WVERCR/Linefollower/readme.md

# LineFollower

lege repository die je als template kan gebruiken om een eigen repository te starten voor uw linefollower project
ward

## specifications

microcontroller: Arduino Leonardo

motors: 50:1 Micro Metal gearmotors HPB 6V

h-bridge: 	DRV8833 Bipolaire Stappenmotor- en DC-Motoraansturing

sensors: QTR8 Reflectance Sensor array 

batteries: 6x AA batterijen 1.5V

wireless communication: 	HC-05 Bluetooth module

distance sensor - motors: /

weight:

speed:
