WVERCR/Linefollower/bill of materials/readme.md

## bill of materials
<br />

|volgnummer|naam |omschrijving |nieuw/recup|kostprijs/stuk|aantal|subtotaal|
|---|---|---|---|---|---|---|
| 1|Microcontroller |Microcontroller arduino leonardo | recup |€ 0 |  1 |€ 0,00 |
| 2|DRV8833 |DRV8833 Bipolaire Stappenmotor- en DC-Motoraansturing | nieuw |€ 3,49 |  1 |€ 3,49 |
| 3|HC-05 |HC-05 Bluetooth module | nieuw |€ 5,00 |  1 |€ 5,00 |
| 4|QTR-8 |Reflectance Sensor array | nieuw |€ 8,18 |  1 |€ 8,18 |
| 5|Motor |50:1 Micro Metal gearmotors HPB 6V | nieuw |€ 2,85 |  1 |€ 2,85 |
| 6|breadbord |breadbord 82mm op 54mm | nieuw |€ 1,72 |  1 |€ 1,72 |
| 7|Batterijen |6x AA batterijen 1.5V | nieuw |€ 11,00 |  1 |€ 11,00  |
| 8|Batterijhouder  |6xAA Batterijhouder | recup |€ 0 |  1 |€ 0 |
| 9|Wielen |Wiel dia:41mm -2 stuks | nieuw |€ 1,94 |  2 |€ 3,88 |
| 10|Drukknop |Drukknop | recup |€ 0 |  1 |€ 0 |
| 11|Led blauw |Blauwe led | recup |€ 0 |  1 |€ 0 |
| 12|Weerstand 220 Ω |Weerstand 220 Ω | recup |€ 0 |  1 |€ 0 |
| 13|Weerstand 680 Ω |Weerstand 680 Ω | recup |€ 0 |  1 |€ 0 |  
| 14|Printplaat |Printplaat 7cm X 9cm | nieuw |€ 1,39 |  1 |€ 1,39 |
| 15|bout en moer |Bout M3*15 en moer M3 | recup |€ 0 |  2 |€ 0 |
| 16|kabels |kabels | nieuw |€ 3,51 |  30  |€ 3,51 |
