WVERCR/Linefollower/code/proof of concepts/hbridge/Schematic_sensor_2024-10-14.pdf

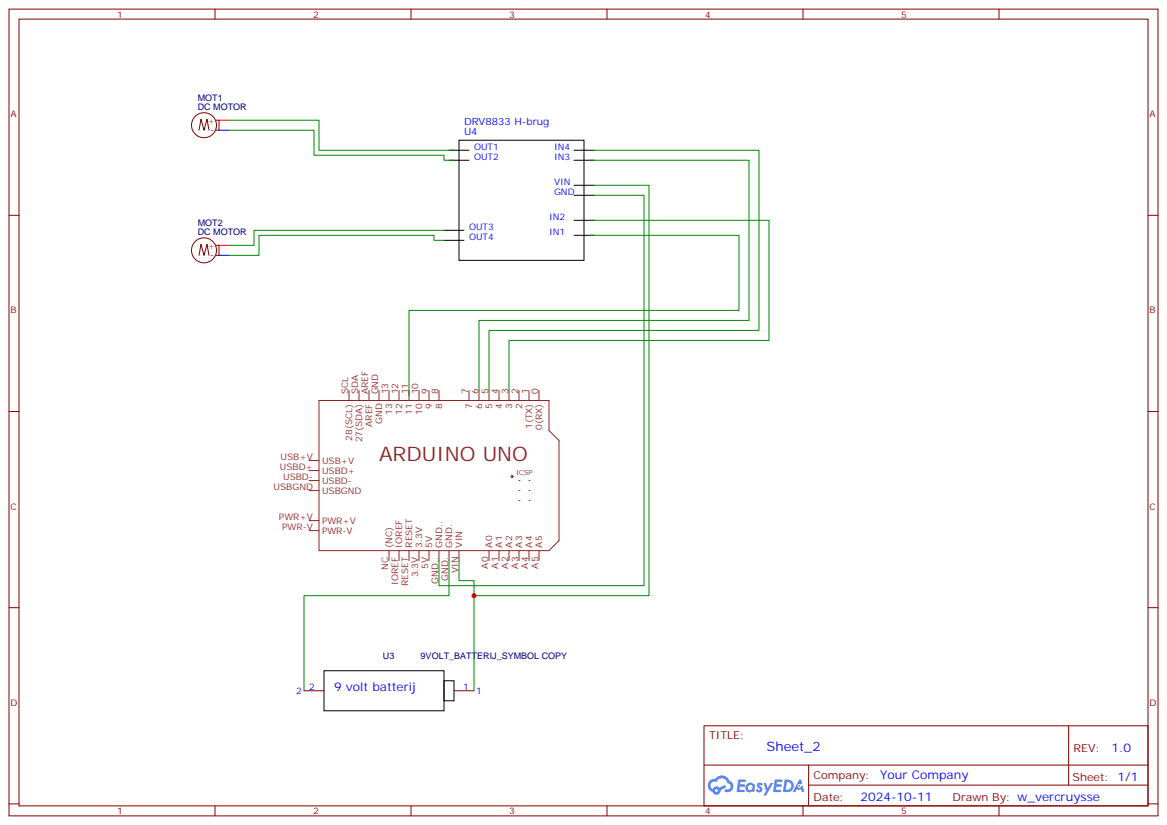
[picture p2: page 1]

9 10 10 11 11 12 12 13 13 GND GND AREF AREF 27(SDA) SDA 28(SCL) SCL
