WVERCR/Linefollower/code/finaal/totaalschema.pdf

## 2 9 volt batterij

HC-05

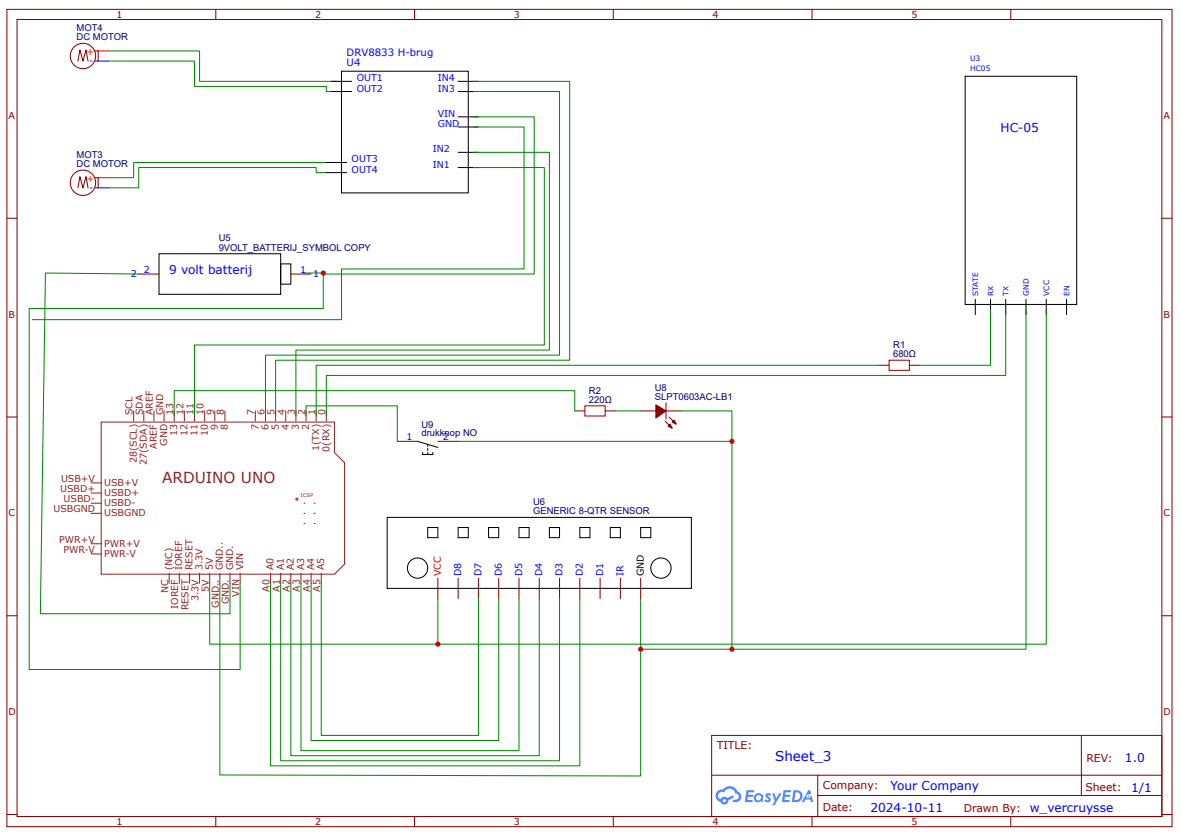
[picture p3: page 1]

VIN GND. GND. GND.. GND..
