WVERCR/Linefollower/technische tekeningen/elektronisch/h-brug.pdf

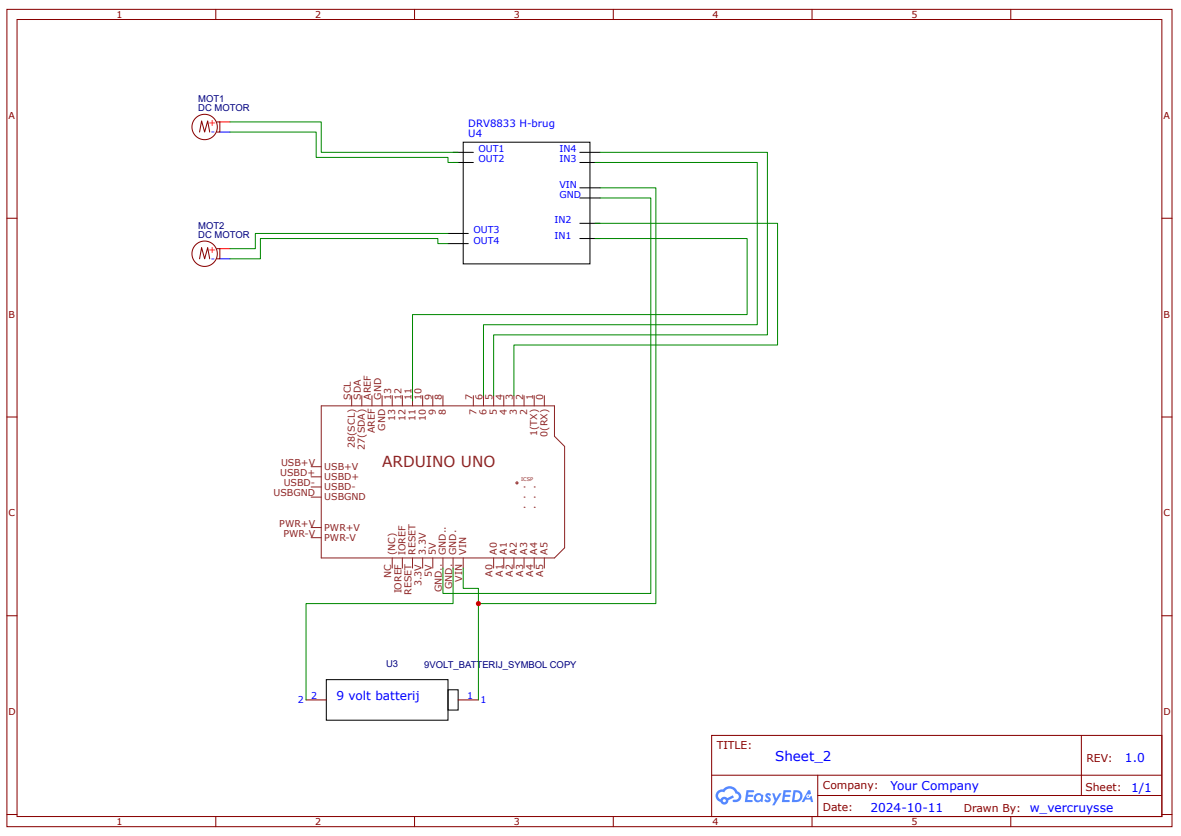
[picture p4: page 1]
TITLE:; Sheet_2; REV: 1.0; Date:; Sheet: 1/1 Drawn By: w_vercruysse; ICSP; USB+V; ARDUINO UNO; USBD+; USBD+ USBD- USBD- USBGND; USBGND; PWR+V; PWR-V; IOREF; RESET RESET 3.3V; GND.. GND.. GND. GND. VIN; VIN; 13 GND GND; AREF AREF 27(SDA) SDA 28(SCL) SCL; 9VOLT_BATTERIJ_SYMBOL COPY; 9 volt batterij; DC MOTOR; MOT1; MOT2; VIN GND; OUT2; OUT1; OUT3 OUT4; DRV8833 H-brug U4

Company: Your Company
