WVERCR/Linefollower/technische tekeningen/elektronisch/communicatie.pdf

HC-05

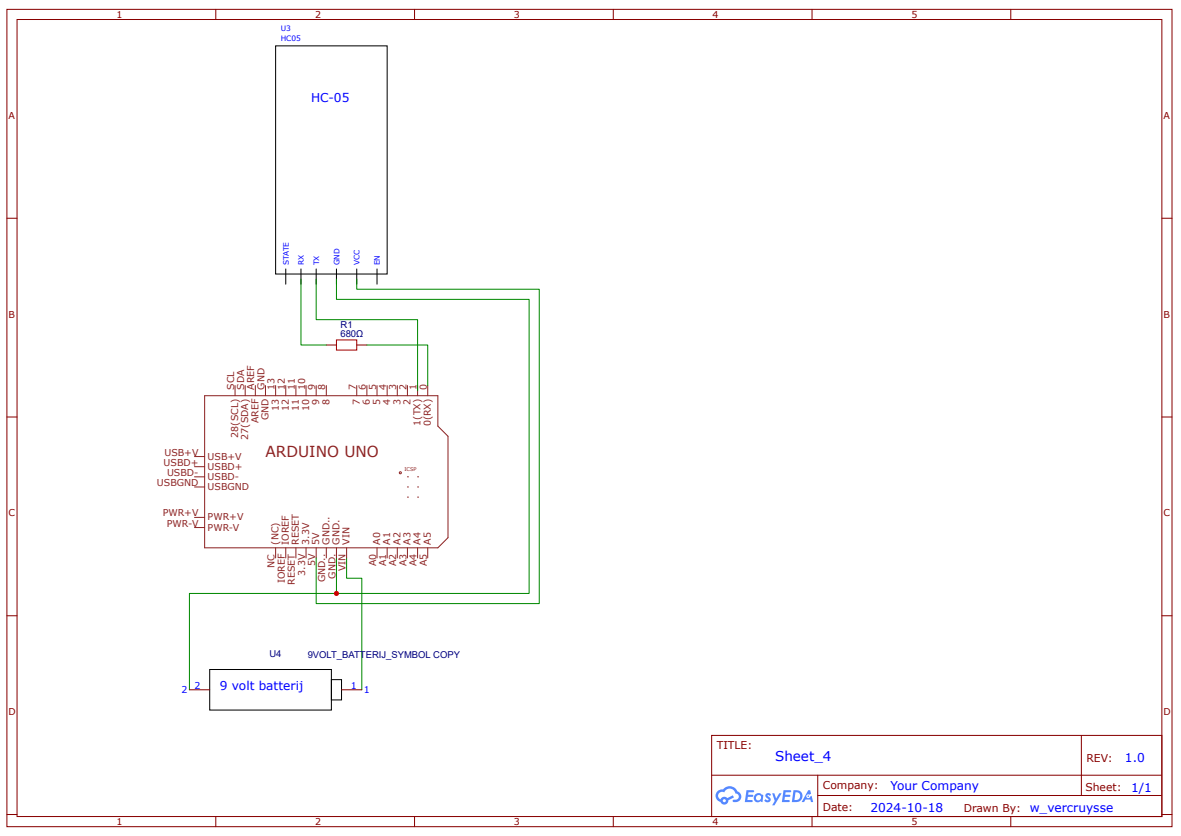
[picture p5: page 1]
TITLE:; Sheet_4; REV: 1.0; Date:; Sheet: 1/1 Drawn By: w_vercruysse; STATE; GND; VCC; 9VOLT_BATTERIJ_SYMBOL COPY; 9 volt batterij; 28(SCL) SCL; 27(SDA) SDA; AREF AREF GND GND; VIN; 3.3V RESET RESET IOREF; IOREF; PWR-V; PWR+V; USBGND; USBD- USBD-; USBD+; USB+V USB+V; ARDUINO UNO; ICSP

VIN GND. GND. GND.. GND..

Company: Your Company
