WVERCR/Linefollower/technische tekeningen/elektronisch/sensor.pdf

## 2 9 volt batterij

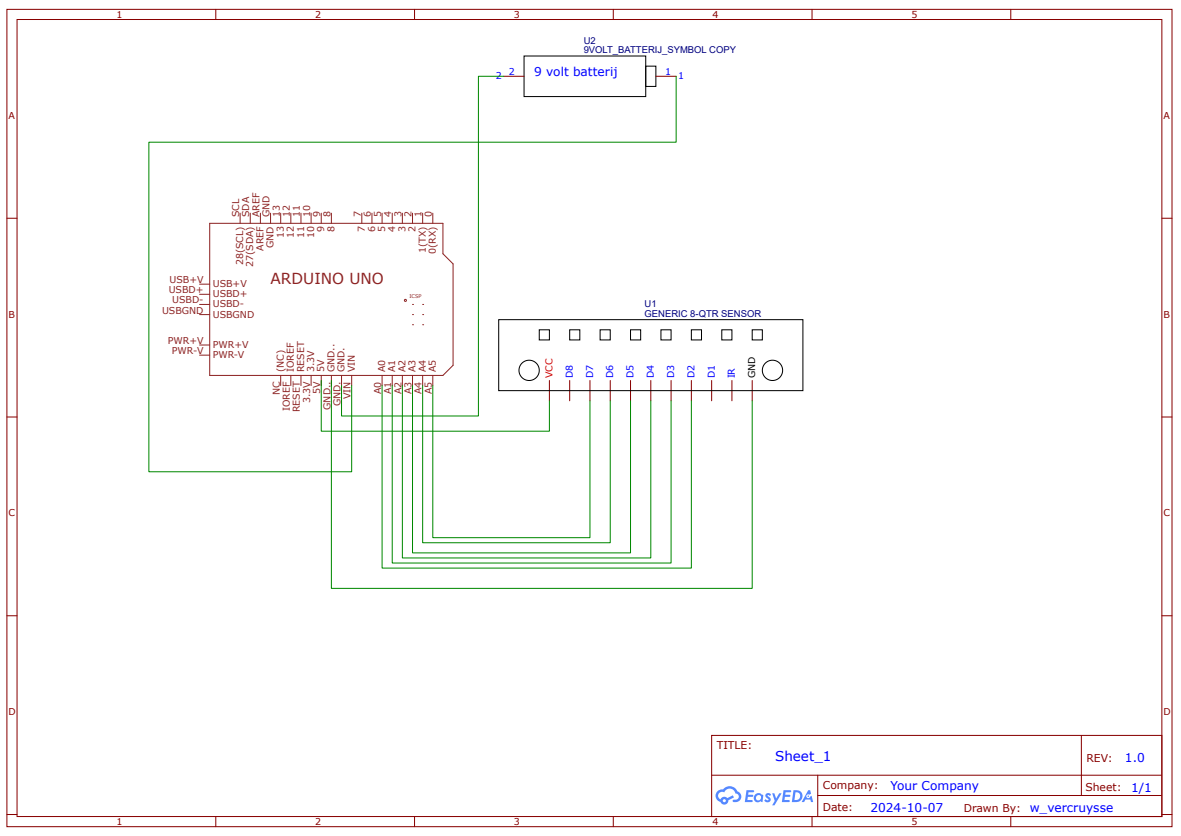
[picture p6: page 1]
