WVERCR/Linefollower/technische tekeningen/elektronisch/interrupt.pdf

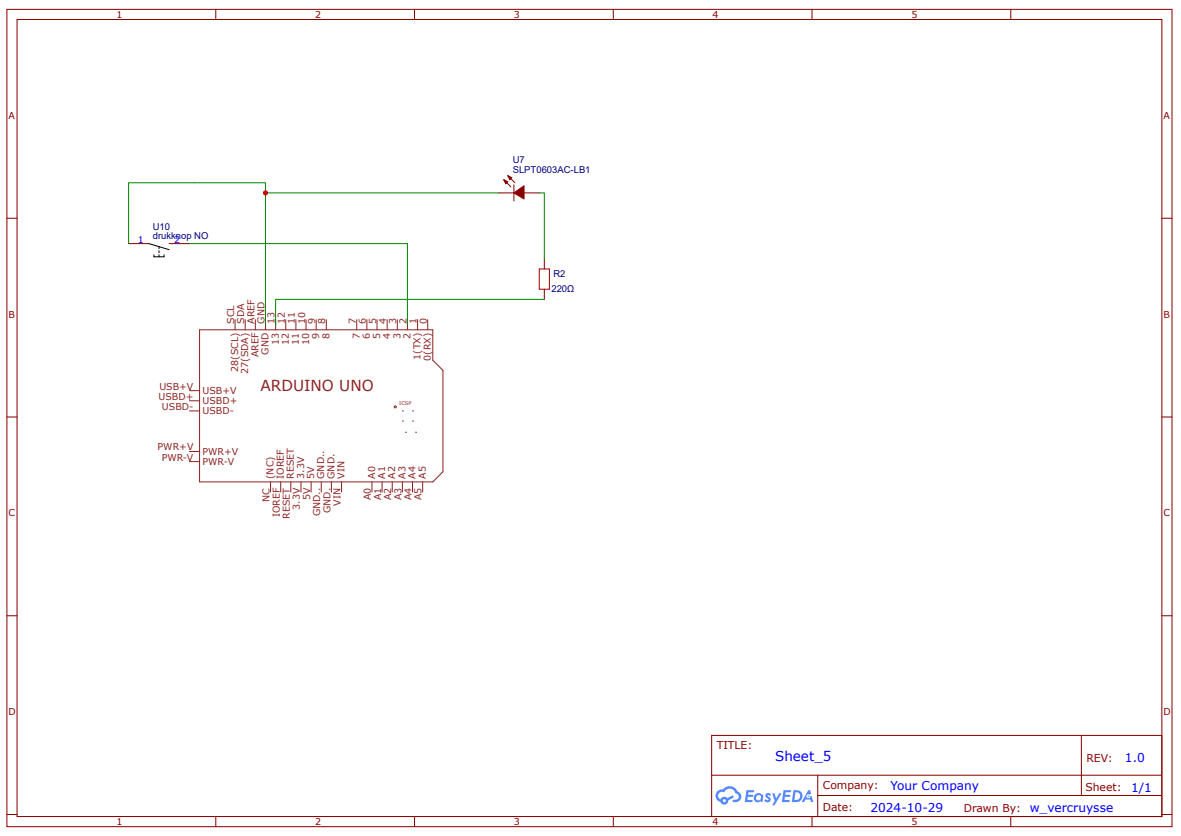
[picture p7: page 1]
TITLE:; Sheet_5; REV: 1.0; Date:; Sheet: 1/1 Drawn By: w_vercruysse; ICSP; USB+V; ARDUINO UNO; USBD+; USBD+ USBD- USBD-; PWR+V; PWR-V; IOREF; RESET RESET 3.3V; GND.. GND.. GND. GND. VIN; VIN; 13 GND GND; AREF AREF 27(SDA) SDA 28(SCL) SCL; SLPT0603AC-LB1; drukknop NO

Company: Your Company
