WVERCR/Linefollower/instructable/readme.md

# Instructable

Een instructable is een stappenplan - zonder verdere uitleg - hoe je vertrekkend van de bill of materials en gebruik makend van de technische tekeningen de robot kan nabouwen. Ook de nodige stappen om de microcontroller te compileren en te uploaden staan beschreven.  

### stap 1
bestel alle componenten uit de bill of materials  
### stap 2
Neem de printplaat en plaats het breakout bord op de printplaat. Het breakout bord zit net wat hogerop de printplaat.
### stap 3
Neem nu de sensor en plaats deze aan de uiteinde van de printplaat ( aan de zijde met het meeste plaats tov het breakout bord). Steek alle nodige draadjes om de sensor aan te sluiten door de gaten in de printplaat en zo in de sensor. Soldeer deze goed zodanig dat de sensor vasthangt.
### stap 4
Neem de 2 motoren en soldeer 2 draden per motor aan de + en - . Plak deze vervolgens met seconde lijm vast op de printplaat ( op de korte afstand tov het breakout bord). Zorg ervoor dat de assen voldoende uitsteken vanuit de printplaat.
### stap 5
Neem nu de wielen en doe wat seconde lijm in het wiel en voldoende op de assen van de motoren. Plak de wielen dan met de uitsteeksels naar buiten op de assen.
### stap 6
De batterijhouder is deze uit de arduino starter kit. Het enige wat we hier moeten meedoen is de draden van het plugsysteem door knippen  en aan de vier draden ( 2 van de houder en 2 van het plugsysteem) soldeer je nu arduino draadjes die je makkelijk in het braekout bord kan stoppen. Zorg dat het soldeersle van alle draden afgeplakt is met plakband voor isolatie.
### stap 7
De batterijhouder kan je nu adhv een wederzijdse plakband op een kant van het breakout bord plakken.
### stap 8
schakel de HC-05 en Hbrug zoals in het elektrisch schema. De h- brug en HC-05 kan je aansluiten op het breakout bord. De arduino kan je gewoon naast de batterijhouder steken doorde lengte van de draden zal deze niet verplaatsen.
### stap 9
Als laatste schakel je nu nog het ledje en de interrupt zoals in het schema. Dit kan ook op het breakout bordje.
### stap 10
Voor een goede werking van de sensor gaan we 2 (M3) bouten in de voorste gaatjes van de printplaat steken. Door deze met 2 moeren ( 1 aan elke kant van de printplaat) vast te maken kunnen we zo de hoogte van de sensor instellen. Dit doe je best adhv de POC van de sensor om zeker te zijn dat je goede waardes hebt.
### stap 11
Nu kan je het finale programma uploaden via de Arduino IDE
### stap 12
Als alles goed is verlopen, werkt het programma goed op de linefollower.
### stap 13
Stel de parameters zoals in de handleiding vermeld om zo goed te kunnen rijden.
### stap 14
Experimenteer met de parameters en geniet van je linefollower
